twwhite/hw-demo-alarm-clock/photos/IMG_20220208_175637.jpg

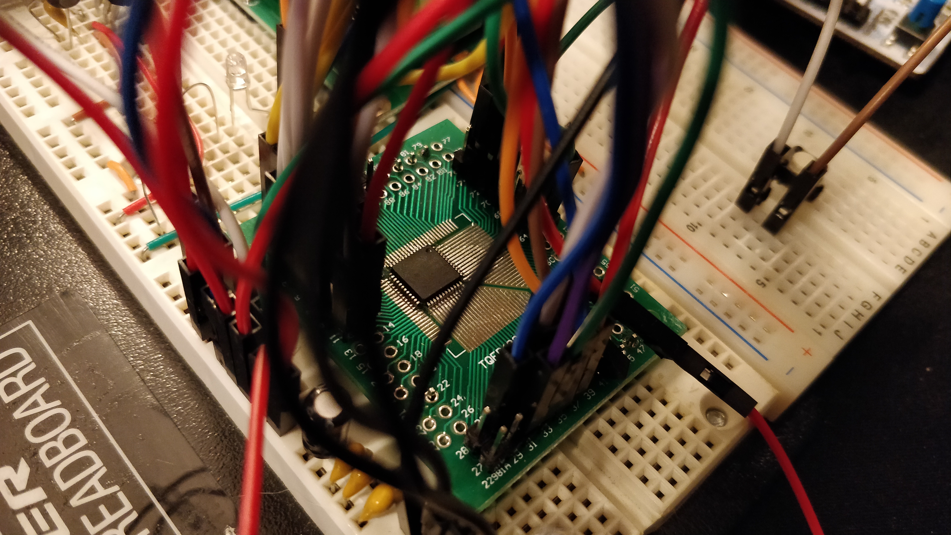
photos/IMG_20220208_175637.jpg
