twwhite/hw-demo-alarm-clock/photos/IMG_20220126_102732.jpg

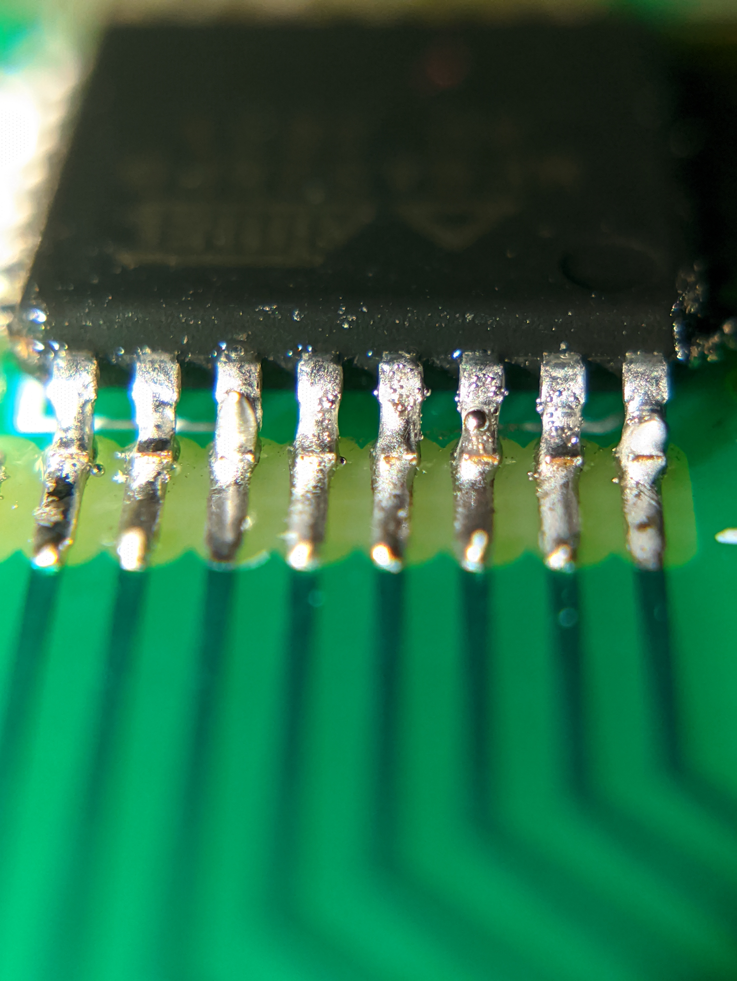
photos/IMG_20220126_102732.jpg
