twwhite/hw-demo-alarm-clock/photos/IMG_20220208_175603.jpg

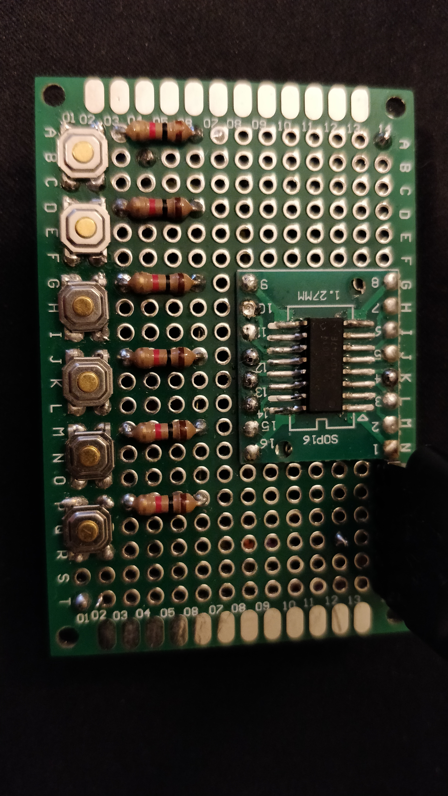
photos/IMG_20220208_175603.jpg
