twwhite/hw-demo-alarm-clock/photos/IMG_20220309_171223.jpg

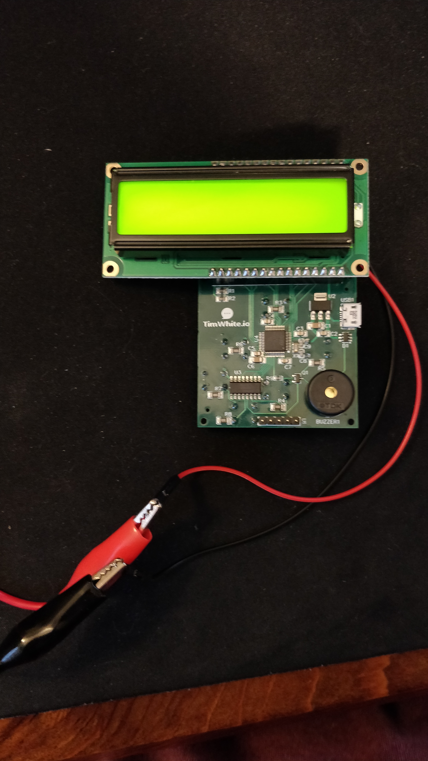
photos/IMG_20220309_171223.jpg
