twwhite/hw-demo-alarm-clock/pcb/BOM_PCB_Alarm Clock V1.0_2022-03-19.csv

ID | Name | Designator | Footprint | Quantity | Manufacturer Part | Manufacturer | Supplier | Supplier Part | Price
1 | B3F-1000 | SW1,SW2,SW3,SW4,SW5,SW6 | KEY-TH_4P-L6.2-W6.2-P4.50-LS6.5 | 6 | B3F-1000 | OMRON | LCSC | C93157
2 | STM32L051C8T6TR | U4 | LQFP-48_L7.0-W7.0-P0.50-LS9.0-BL | 1 | STM32L051C8T6TR | ST(意法半导体) | LCSC | C2802165
3 | S8050_C2146 | Q1 | SOT-23-3_L3.0-W1.7-P0.95-LS2.9-BR | 1 | S8050 | CJ | LCSC | C2146
4 | 1kΩ | R9 | R0603 | 1 | 0603WAF1001T5E | UniOhm | LCSC | C21190
5 | 10uF | C1,C6 | C1206 | 2 | CL31A106KBHNNNE | SAMSUNG | LCSC | C13585
6 | 100nF | C2,C3,C4,C5,C7 | C0805 | 5 | CL21B104KCFNNNE | SAMSUNG | LCSC | C28233
7 | 15pF | C8,C9 | C0603 | 2 | CL10C150JB8NNNC | SAMSUNG | LCSC | C1644
8 | USBLC6-2SC6 | D1 | SOT-23-6_L2.9-W1.6-P0.95-LS2.8-BR | 1 | USBLC6-2SC6 | STMicroelectronics | LCSC | C7519
9 | Headers-Female-2.54_1x16 | P1 | HDR-TH_16P-P2.54-V-F-1 | 1 | Female header1*16P pitch 2.54mm | BOOMELE | LCSC | C66987
10 | 33kΩ | R1 | R0805 | 1 | 0805W8F3302T5E | UniOhm | LCSC | C17633
11 | 2.2kΩ | R2 | R0805 | 1 | 0805W8F2201T5E | UniOhm | LCSC | C17520
12 | MTP125-1105S1 | U1 | HDR-TH_5P-P2.54-V-M | 1 | MTP125-1105S1 | MINTRON | LCSC | C358687
13 | AMS1117-3.3 | U2 | SOT-223-3_L6.5-W3.4-P2.30-LS7.0-BR | 1 | AMS1117-3.3 | AMS | LCSC | C6186
14 | 74HC165D,653 | U3 | SOIC-16_L9.9-W3.9-P1.27-LS6.0-BL | 1 | 74HC165D,653 | Nexperia | LCSC | C5613
15 | 47346-0001 | USB1 | MICRO-USB-SMD_47346-0001 | 1 | 47346-0001 | MOLEX | LCSC | C132560
16 | 32.768kHz | X1 | FC-135R_L3.2-W1.5 | 1 | Q13FC1350000400 | EPSON | LCSC | C32346
17 | 100Ω | R3,R4,R5,R6,R7,R8 | R1206 | 6 | 1206W4F1000T5E | UniOhm | LCSC | C17901
18 | PS1420P02CT | BUZZER1 | BUZ-TH_BD14.0-P5.00-D0.7-FD | 1 | PS1420P02CT | TDK | LCSC | C91080
