twwhite/hw-demo-alarm-clock/pcb/Schematic_Alarm Clock V1.0_2022-03-19.pdf

+5V

## Fixed 5V to 3.3V LDO

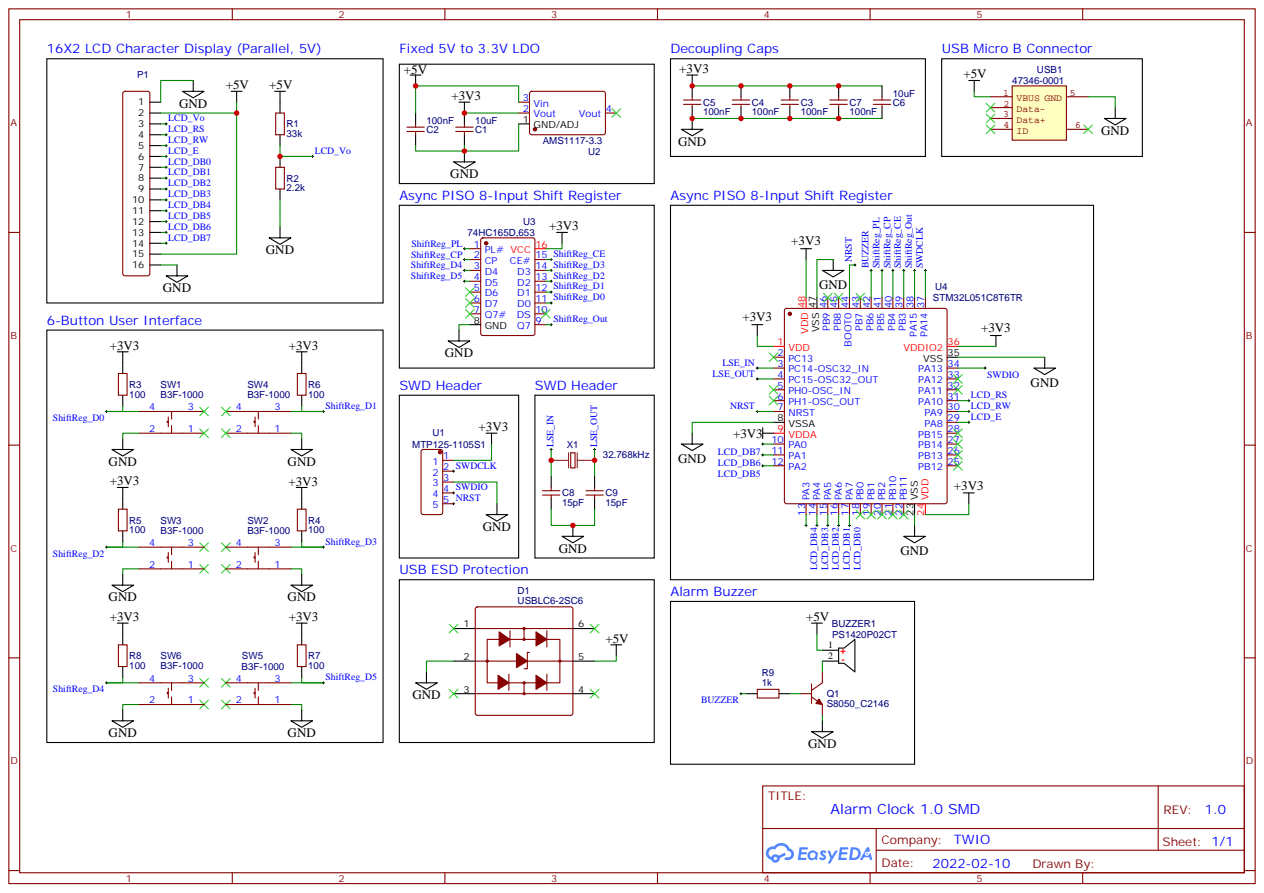
[picture p6: page 1]

16X2 LCD Character Display (Parallel, 5V)

Async PISO 8-Input Shift Register
